grbd/bobc_hardware/CRAMPS/CRAMPS.kicad_pcb

## KiCad design CRAMPS/CRAMPS.kicad_pcb (2015-11-11)

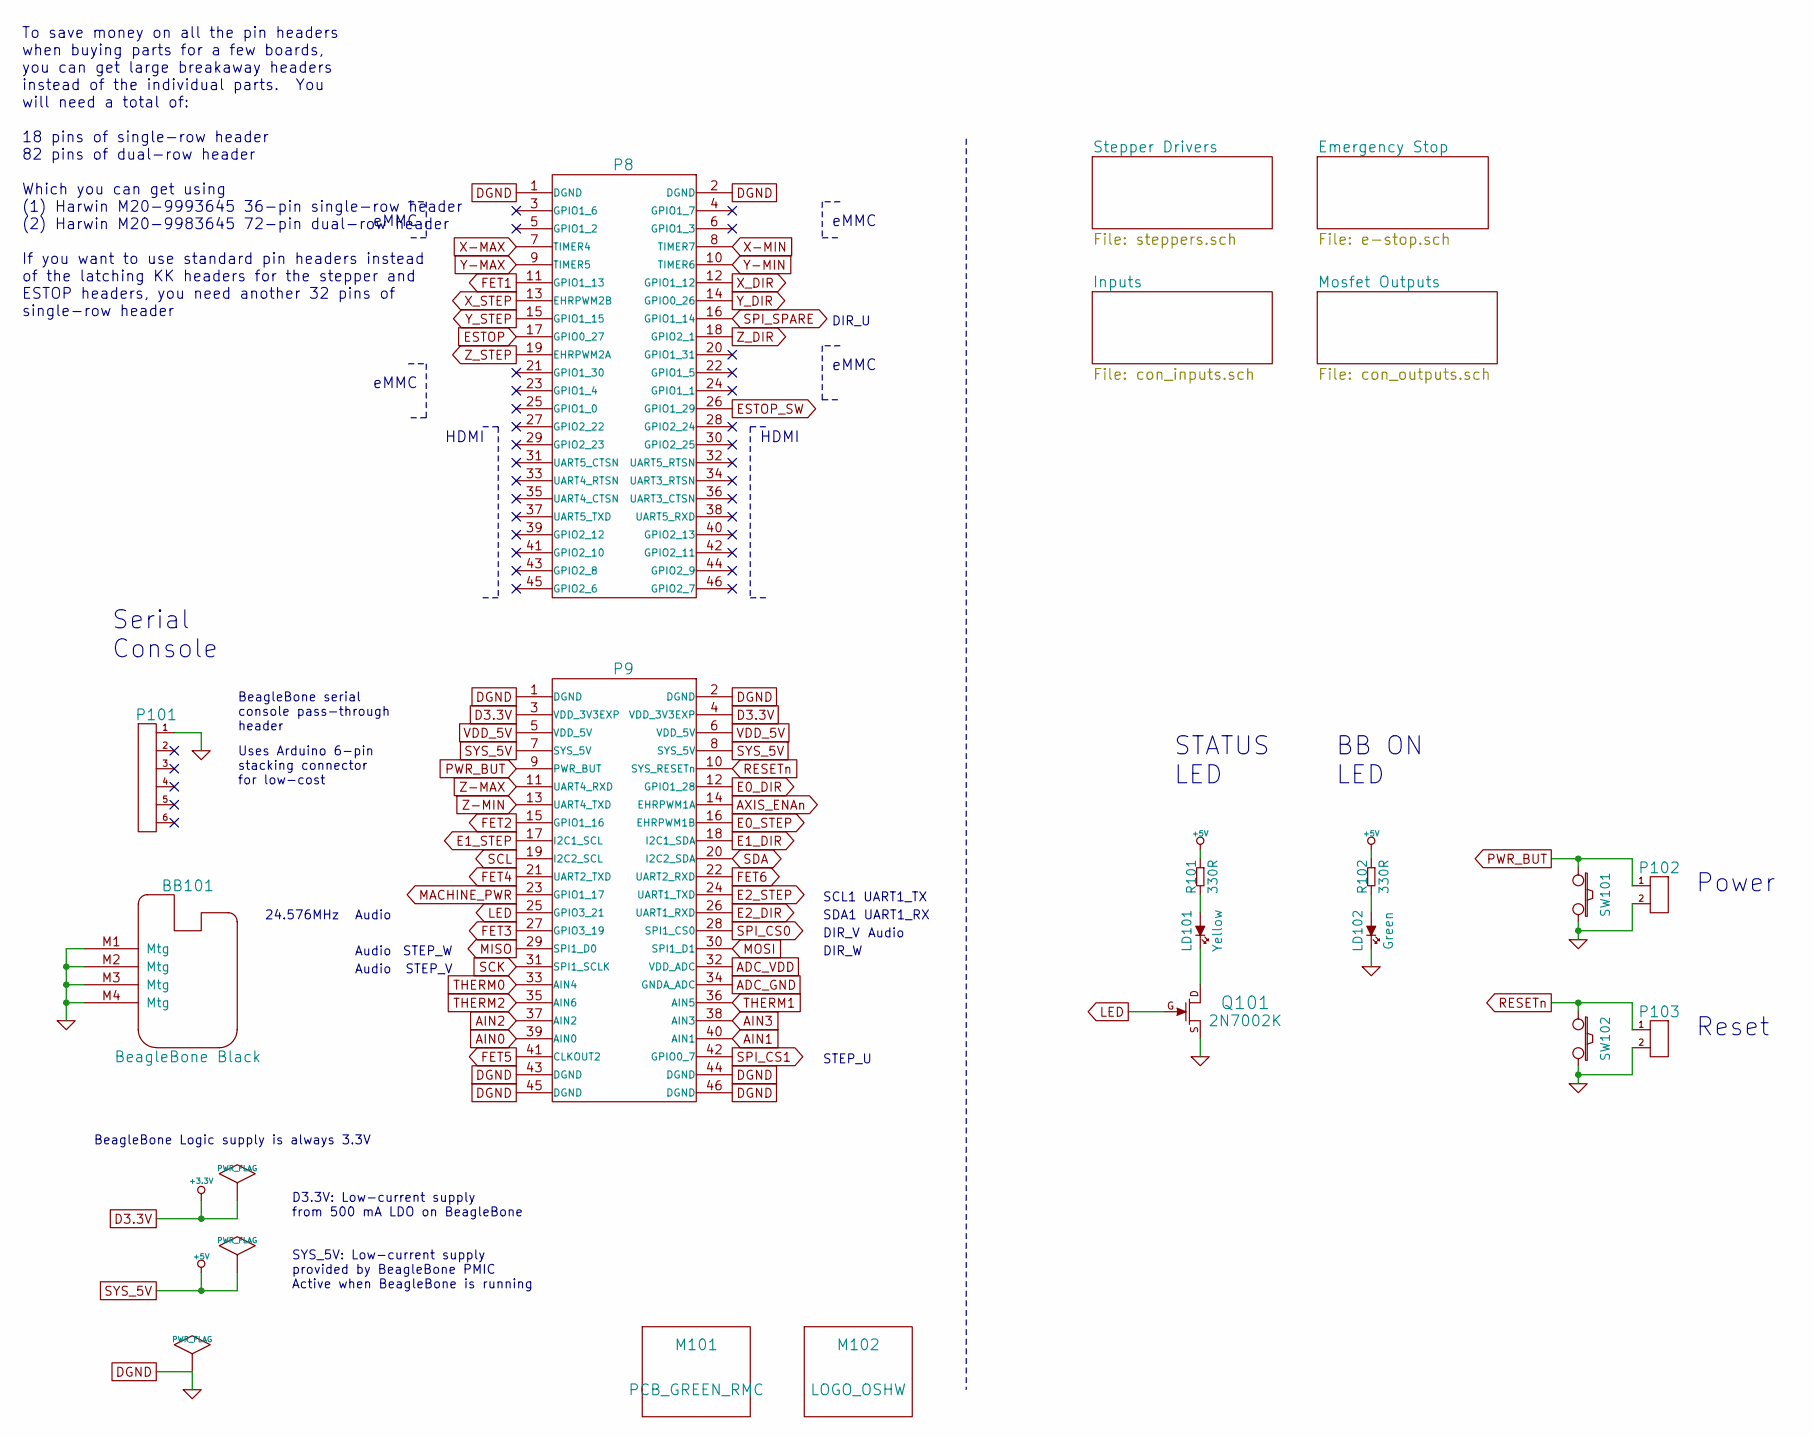
[picture p1: schematic CRAMPS.sch, CRAMPS (Cape-RAMPS for BeagleBone)]

Parts:
BB101: BeagleBone Black; BeagleBone-Pins; PartNo BB-BBLK-000
LD101: Yellow; OSRAM-LED-0603; PartNo LY Q976-P1S2-36
LD102: Green; OSRAM-LED-0603; PartNo LG Q971-KN-1
M101: PCB_GREEN_RMC; OSHW_logo_2; PartNo Part of PCB
M102: LOGO_OSHW; PCB_GREEN_RMC; PartNo Part of PCB
P8, P9: BB_EXP_CONN; P8P9_PinHeader; PartNo TSHC-123-D-06-240-GT-LF
P101: SOCKET_6_LONG; pin_strip_6; PartNo PRT-09280
P102, P103: HEADER_2; pin_strip_2; PartNo M20-9990245
Q101: 2N7002K; SOT23GDS; PartNo 2N7002K-7
R101, R102: 330R; RESC1608x55N; PartNo RMCF0603FT330R
SW101, SW102: SW_PUSH; SW_6x6_MULTI; PartNo FSM2JH

Connections:
ADC_GND: P9.34 (GNDA_ADC); also elsewhere on the board
ADC_VDD: P9.32 (VDD_ADC); also elsewhere on the board
AIN0: P9.39 (AIN0); also elsewhere on the board
AIN1: P9.40 (AIN1); also elsewhere on the board
AIN2: P9.37 (AIN2); also elsewhere on the board
AIN3: P9.38 (AIN3); also elsewhere on the board
AXIS_ENAn: P9.14 (EHRPWM1A); also elsewhere on the board
D3.3V: P9.3 (VDD_3V3EXP), P9.4 (VDD_3V3EXP); also elsewhere on the board
DGND: BB101.M1, BB101.M2, BB101.M3, BB101.M4, LD102.K, P8.1 (DGND), P8.2 (DGND), P9.1 (DGND), P9.2 (DGND), P9.43 (DGND), P9.44 (DGND), P9.45 (DGND), P9.46 (DGND), P101.1, P102.2, P103.2, Q101.S, SW101.2, SW102.2; also elsewhere on the board
E0_DIR: P9.12 (GPIO1_28); also elsewhere on the board
E0_STEP: P9.16 (EHRPWM1B); also elsewhere on the board
E1_DIR: P9.18 (I2C1_SDA); also elsewhere on the board
E1_STEP: P9.17 (I2C1_SCL); also elsewhere on the board
E2_DIR: P9.26 (UART1_RXD); also elsewhere on the board
E2_STEP: P9.24 (UART1_TXD); also elsewhere on the board
ESTOP: P8.17 (GPIO0_27); also elsewhere on the board
ESTOP_SW: P8.26 (GPIO1_29); also elsewhere on the board
FET1: P8.11 (GPIO1_13); also elsewhere on the board
FET2: P9.15 (GPIO1_16); also elsewhere on the board
FET3: P9.27 (GPIO3_19); also elsewhere on the board
FET4: P9.21 (UART2_TXD); also elsewhere on the board
FET5: P9.41 (CLKOUT2); also elsewhere on the board
FET6: P9.22 (UART2_RXD); also elsewhere on the board
LED: P9.25 (GPIO3_21), Q101.G
MACHINE_PWR: P9.23 (GPIO1_17); also elsewhere on the board
MISO: P9.29 (SPI1_D0); also elsewhere on the board
MOSI: P9.30 (SPI1_D1); also elsewhere on the board
unnamed: LD101.A, R101.2
unnamed: LD101.K, Q101.D
unnamed: LD102.A, R102.2
PWR_BUT: P9.9 (PWR_BUT), P102.1, SW101.1
RESETn: P9.10 (SYS_RESETn), P103.1, SW102.1
SCK: P9.31 (SPI1_SCLK); also elsewhere on the board
SCL: P9.19 (I2C2_SCL); also elsewhere on the board
SDA: P9.20 (I2C2_SDA); also elsewhere on the board
SPI_CS0: P9.28 (SPI1_CS0); also elsewhere on the board
SPI_CS1: P9.42 (GPIO0_7); also elsewhere on the board
SPI_SPARE: P8.16 (GPIO1_14); also elsewhere on the board
SYS_5V: P9.7 (SYS_5V), P9.8 (SYS_5V), R101.1, R102.1; also elsewhere on the board
THERM0: P9.33 (AIN4); also elsewhere on the board
THERM1: P9.36 (AIN5); also elsewhere on the board
THERM2: P9.35 (AIN6); also elsewhere on the board
VDD_5V: P9.5 (VDD_5V), P9.6 (VDD_5V); also elsewhere on the board
X-MAX: P8.7 (TIMER4); also elsewhere on the board
X-MIN: P8.8 (TIMER7); also elsewhere on the board
X_DIR: P8.12 (GPIO1_12); also elsewhere on the board
X_STEP: P8.13 (EHRPWM2B); also elsewhere on the board
Y-MAX: P8.9 (TIMER5); also elsewhere on the board
Y-MIN: P8.10 (TIMER6); also elsewhere on the board
Y_DIR: P8.14 (GPIO0_26); also elsewhere on the board
Y_STEP: P8.15 (GPIO1_15); also elsewhere on the board
Z-MAX: P9.11 (UART4_RXD); also elsewhere on the board
Z-MIN: P9.13 (UART4_TXD); also elsewhere on the board
Z_DIR: P8.18 (GPIO2_1); also elsewhere on the board
Z_STEP: P8.19 (EHRPWM2A); also elsewhere on the board

Notes on the sheet:
STATUS LED
HDMI
eMMC
24.576MHz
Audio
BeagleBone serial console pass-through header
SCL1 UART1_TX
SDA1 UART1_RX
To save money on all the pin headers when buying parts for a few boards, you can get large breakaway headers instead of the individual parts. You will need a total of: 18 pins of single-row header 82 pins of dual-row header Which you can get using (1) Harwin M20-9993645 36-pin single-row header (2)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
BB ON LED
BeagleBone Logic supply is always 3.3V
SYS_5V: Low-current supply provided by BeagleBone PMIC Active when BeagleBone is running
D3.3V: Low-current supply from 500 mA LDO on BeagleBone
Serial Console
Uses Arduino 6-pin stacking connector for low-cost
Power
Reset
STEP_U
STEP_V
STEP_W
DIR_U
DIR_V
DIR_W

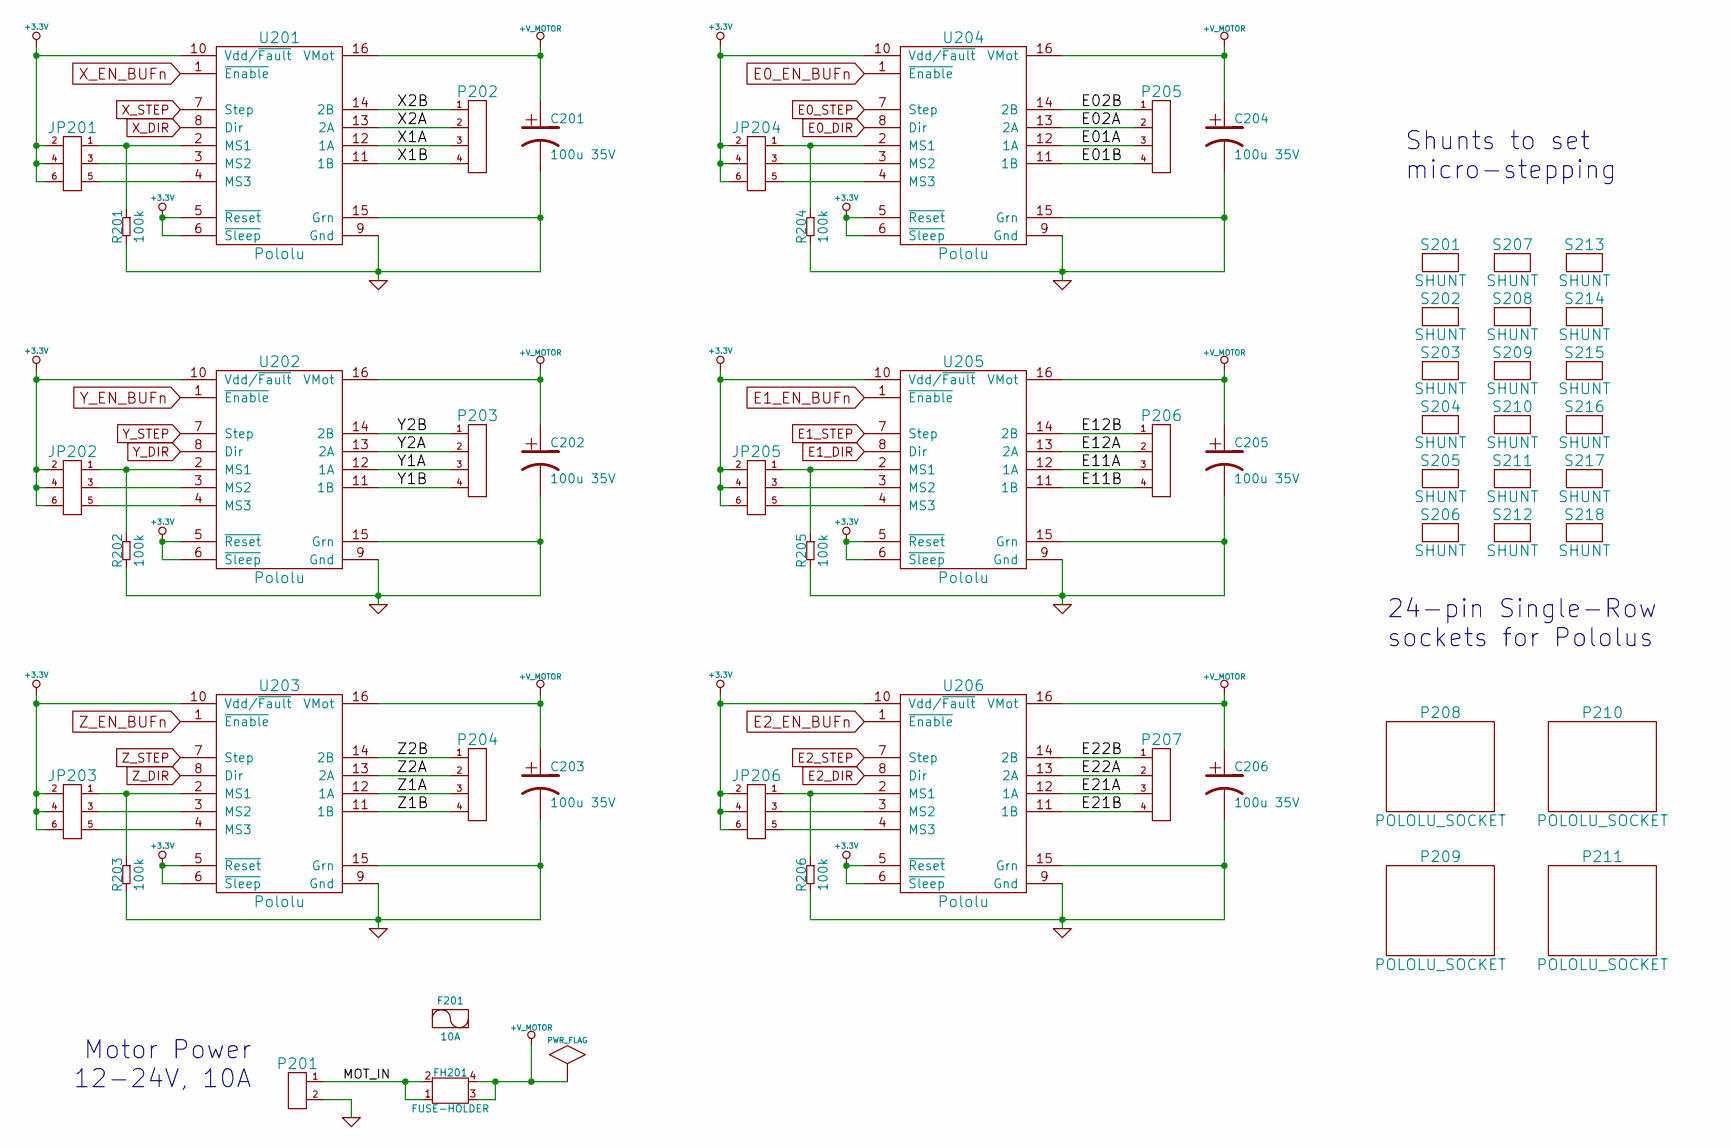
[picture p2: schematic steppers.sch, CRAMPS (Cape-RAMPS for BeagleBone)]

Parts:
C201, C202, C203, C204, C205, C206: 100u 35V; c_elec_6.3x7.7; PartNo UCD1V101MCL6GS
F201: 10A; Fuse-Loose; PartNo 0297010.WXNV
FH201: FUSE-HOLDER; Keystone-3568; PartNo 3568
JP201, JP202, JP203, JP204, JP205, JP206: HEADER_3X2; pin_strip_3x2; PartNo M20-9980345
P201: PT_2,5-2-5,0-H; PartNo 1935776
P202, P203, P204, P205, P206, P207: KK-2.54-4W; CONN_KK_2.54_4W; PartNo 22-23-2041
P208, P209, P210, P211: POLOLU_SOCKET; Pololu_Socket; PartNo PPTC241LFBN-RC
R201, R202, R203, R204, R205, R206: 100k; RESC1608x55N; PartNo RMCF0603FT100K
S201, S202, S203, S204, S205, S206, S207, S208, S209, S210, S211, S212, S213, S214, S215, S216, S217, S218: SHUNT; Shunt; PartNo 382811-8
U201, U202, U203, U204, U205, U206: Pololu; POLOLU; PartNo DRV8825

Connections:
+V_MOTOR: C201.1, C202.1, C203.1, C204.1, C205.1, C206.1, FH201.3, FH201.4, U201.16 (VMot), U202.16 (VMot), U203.16 (VMot), U204.16 (VMot), U205.16 (VMot), U206.16 (VMot); also elsewhere on the board
/Stepper Drivers/E01A: P205.3, U204.12 (1A)
/Stepper Drivers/E01B: P205.4, U204.11 (1B)
/Stepper Drivers/E02A: P205.2, U204.13 (2A)
/Stepper Drivers/E02B: P205.1, U204.14 (2B)
/Stepper Drivers/E11A: P206.3, U205.12 (1A)
/Stepper Drivers/E11B: P206.4, U205.11 (1B)
/Stepper Drivers/E12A: P206.2, U205.13 (2A)
/Stepper Drivers/E12B: P206.1, U205.14 (2B)
/Stepper Drivers/E21A: P207.3, U206.12 (1A)
/Stepper Drivers/E21B: P207.4, U206.11 (1B)
/Stepper Drivers/E22A: P207.2, U206.13 (2A)
/Stepper Drivers/E22B: P207.1, U206.14 (2B)
/Stepper Drivers/MOT_IN: FH201.1, FH201.2, P201.1
/Stepper Drivers/X1A: P202.3, U201.12 (1A)
/Stepper Drivers/X1B: P202.4, U201.11 (1B)
/Stepper Drivers/X2A: P202.2, U201.13 (2A)
/Stepper Drivers/X2B: P202.1, U201.14 (2B)
/Stepper Drivers/Y1A: P203.3, U202.12 (1A)
/Stepper Drivers/Y1B: P203.4, U202.11 (1B)
/Stepper Drivers/Y2A: P203.2, U202.13 (2A)
/Stepper Drivers/Y2B: P203.1, U202.14 (2B)
/Stepper Drivers/Z1A: P204.3, U203.12 (1A)
/Stepper Drivers/Z1B: P204.4, U203.11 (1B)
/Stepper Drivers/Z2A: P204.2, U203.13 (2A)
/Stepper Drivers/Z2B: P204.1, U203.14 (2B)
D3.3V: JP201.2, JP201.4, JP201.6, JP202.2, JP202.4, JP202.6, JP203.2, JP203.4, JP203.6, JP204.2, JP204.4, JP204.6, JP205.2, JP205.4, JP205.6, JP206.2, JP206.4, JP206.6, U201.5 (~Reset), U201.6 (~Sleep), U201.10 (Vdd/~Fault), U202.5 (~Reset), U202.6 (~Sleep), U202.10 (Vdd/~Fault), U203.5 (~Reset), U203.6 (~Sleep), U203.10 (Vdd/~Fault), U204.5 (~Reset), U204.6 (~Sleep), U204.10 (Vdd/~Fault), U205.5 (~Reset), U205.6 (~Sleep), U205.10 (Vdd/~Fault), U206.5 (~Reset), U206.6 (~Sleep), U206.10 (Vdd/~Fault); also elsewhere on the board
DGND: C201.2, C202.2, C203.2, C204.2, C205.2, C206.2, P201.2, R201.2, R202.2, R203.2, R204.2, R205.2, R206.2, U201.9 (Gnd), U201.15 (Grn), U202.9 (Gnd), U202.15 (Grn), U203.9 (Gnd), U203.15 (Grn), U204.9 (Gnd), U204.15 (Grn), U205.9 (Gnd), U205.15 (Grn), U206.9 (Gnd), U206.15 (Grn); also elsewhere on the board
E0_DIR: U204.8 (Dir); also elsewhere on the board
E0_EN_BUFn: U201.1 (~Enable), U202.1 (~Enable), U203.1 (~Enable), U204.1 (~Enable), U205.1 (~Enable), U206.1 (~Enable); also elsewhere on the board
E0_STEP: U204.7 (Step); also elsewhere on the board
E1_DIR: U205.8 (Dir); also elsewhere on the board
E1_STEP: U205.7 (Step); also elsewhere on the board
E2_DIR: U206.8 (Dir); also elsewhere on the board
E2_STEP: U206.7 (Step); also elsewhere on the board
unnamed: JP201.1, R201.1, U201.2 (MS1)
unnamed: JP201.3, U201.3 (MS2)
unnamed: JP201.5, U201.4 (MS3)
unnamed: JP202.1, R202.1, U202.2 (MS1)
unnamed: JP202.3, U202.3 (MS2)
unnamed: JP202.5, U202.4 (MS3)
unnamed: JP203.1, R203.1, U203.2 (MS1)
unnamed: JP203.3, U203.3 (MS2)
unnamed: JP203.5, U203.4 (MS3)
unnamed: JP204.1, R204.1, U204.2 (MS1)
unnamed: JP204.3, U204.3 (MS2)
unnamed: JP204.5, U204.4 (MS3)
unnamed: JP205.1, R205.1, U205.2 (MS1)
unnamed: JP205.3, U205.3 (MS2)
unnamed: JP205.5, U205.4 (MS3)
unnamed: JP206.1, R206.1, U206.2 (MS1)
unnamed: JP206.3, U206.3 (MS2)
unnamed: JP206.5, U206.4 (MS3)
X_DIR: U201.8 (Dir); also elsewhere on the board
X_STEP: U201.7 (Step); also elsewhere on the board
Y_DIR: U202.8 (Dir); also elsewhere on the board
Y_STEP: U202.7 (Step); also elsewhere on the board
Z_DIR: U203.8 (Dir); also elsewhere on the board
Z_STEP: U203.7 (Step); also elsewhere on the board

Notes on the sheet:
Motor Power 12-24V, 10A
24-pin Single-Row sockets for Pololus
Shunts to set micro-stepping

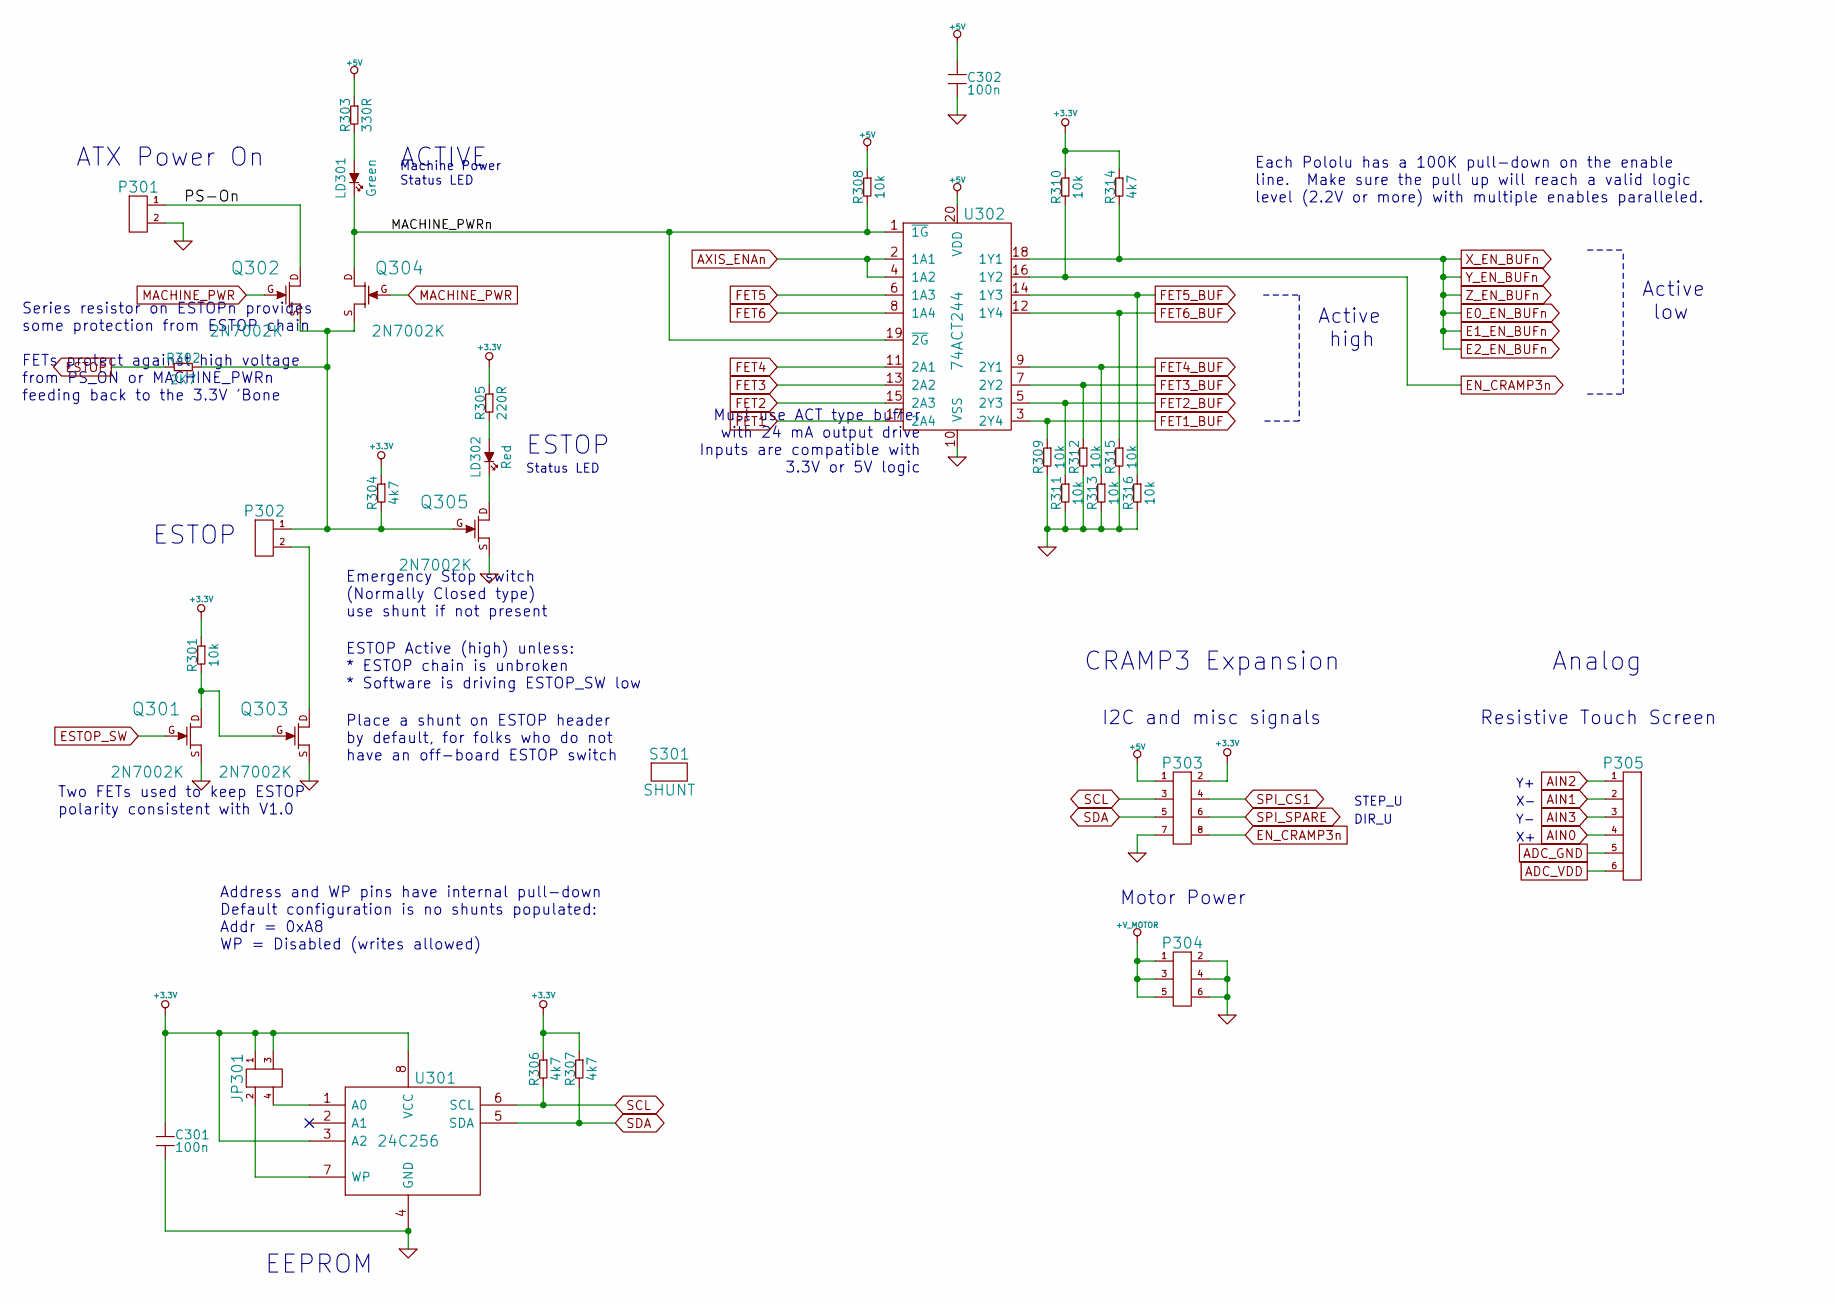
[picture p3: schematic e-stop.sch, CRAMPS (Cape-RAMPS for BeagleBone)]

Parts:
C301, C302: 100n; CAPC1608x55N; PartNo GRM188R71C104KA01D
JP301: HEADER_2X2; pin_strip_2x2; PartNo M20-9980245
LD301: Green; OSRAM-LED-0603; PartNo LG Q971-KN-1
LD302: Red; OSRAM-LED-0603; PartNo LS Q976-NR-1
P301: HEADER_2; pin_strip_2; PartNo M20-9990245
P302: KK-2.54-2W; CONN_KK_2.54_2W; PartNo 22-23-2021
P303: HEADER_4X2; pin_strip_4x2; PartNo M20-9980445
P304: HEADER_3X2; pin_strip_3x2; PartNo M20-9980345
P305: HEADER_6; pin_strip_6; PartNo M20-9990645
Q301, Q302, Q303, Q304, Q305: 2N7002K; SOT23GDS; PartNo 2N7002K-7
R301, R308, R309, R310, R311, R312, R313, R315, R316: 10k; RESC1608x55N; PartNo RMCF0603FT10K0
R302: 2K7; RESC1608x55N; PartNo RMCF0603FT2K70
R303: 330R; RESC1608x55N; PartNo RMCF0603FT330R
R304, R306, R307, R314: 4k7; RESC1608x55N; PartNo RMCF0603FT4K70
R305: 220R; RESC1608x55N; PartNo RMCF0603FT220R
S301: SHUNT; Shunt; PartNo 382811-8
U301: 24C256; SOIC127P600X175-8AN; PartNo CAT24C256WI-GT3
U302: 74ACT244; SOIC127P1032X265-20N; PartNo 74ACT244SCX

Connections:
+V_MOTOR: P304.1, P304.3, P304.5; also elsewhere on the board
/Emergency Stop/MACHINE_PWRn: LD301.K, Q304.D, R308.2, U302.1 (~1G), U302.19 (~2G)
/Emergency Stop/PS-On: P301.1, Q302.D
ADC_GND: P305.5; also elsewhere on the board
ADC_VDD: P305.6; also elsewhere on the board
AIN0: P305.4; also elsewhere on the board
AIN1: P305.2; also elsewhere on the board
AIN2: P305.1; also elsewhere on the board
AIN3: P305.3; also elsewhere on the board
AXIS_ENAn: U302.2 (1A1), U302.4 (1A2); also elsewhere on the board
D3.3V: C301.1, JP301.1, JP301.3, P303.2, R301.1, R304.1, R305.1, R306.1, R307.1, R310.1, R314.1, U301.3 (A2), U301.8 (VCC); also elsewhere on the board
DGND: C301.2, C302.2, P301.2, P303.7, P304.2, P304.4, P304.6, Q301.S, Q303.S, Q305.S, R309.2, R311.2, R312.2, R313.2, R315.2, R316.2, U301.4 (GND), U302.10 (VSS); also elsewhere on the board
E0_EN_BUFn: R314.2, U302.18 (1Y1); also elsewhere on the board
EN_CRAMP3n: P303.8, R310.2, U302.16 (1Y2)
ESTOP: R302.2; also elsewhere on the board
ESTOP_SW: Q301.G; also elsewhere on the board
FET1: U302.17 (2A4); also elsewhere on the board
FET1_BUF: R309.1, U302.3 (2Y4); also elsewhere on the board
FET2: U302.15 (2A3); also elsewhere on the board
FET2_BUF: R311.1, U302.5 (2Y3); also elsewhere on the board
FET3: U302.13 (2A2); also elsewhere on the board
FET3_BUF: R312.1, U302.7 (2Y2); also elsewhere on the board
FET4: U302.11 (2A1); also elsewhere on the board
FET4_BUF: R313.1, U302.9 (2Y1); also elsewhere on the board
FET5: U302.6 (1A3); also elsewhere on the board
FET5_BUF: R316.1, U302.14 (1Y3); also elsewhere on the board
FET6: U302.8 (1A4); also elsewhere on the board
FET6_BUF: R315.1, U302.12 (1Y4); also elsewhere on the board
MACHINE_PWR: Q302.G, Q304.G; also elsewhere on the board
unnamed: JP301.2, U301.7 (WP)
unnamed: JP301.4, U301.1 (A0)
unnamed: LD301.A, R303.2
unnamed: LD302.A, R305.2
unnamed: LD302.K, Q305.D
unnamed: P302.1, Q302.S, Q304.S, Q305.G, R302.1, R304.2
unnamed: P302.2, Q303.D
unnamed: Q301.D, Q303.G, R301.2
SCL: P303.3, R306.2, U301.6 (SCL); also elsewhere on the board
SDA: P303.5, R307.2, U301.5 (SDA); also elsewhere on the board
SPI_CS1: P303.4; also elsewhere on the board
SPI_SPARE: P303.6; also elsewhere on the board
SYS_5V: C302.1, P303.1, R303.1, R308.1, U302.20 (VDD); also elsewhere on the board

Notes on the sheet:
Emergency Stop switch (Normally Closed type) use shunt if not present
Active low
Active high
Must use ACT type buffer with 24 mA output drive Inputs are compatible with 3.3V or 5V logic
Each Pololu has a 100K pull-down on the enable line. Make sure the pull up will reach a valid logic level (2.2V or more) with multiple enables paralleled.
ESTOP Active (high) unless: * ESTOP chain is unbroken * Software is driving ESTOP_SW low
Machine Power Status LED
EEPROM
Address and WP pins have internal pull-down Default configuration is no shunts populated: Addr = 0xA8 WP = Disabled (writes allowed)
I2C and misc signals
Analog
Resistive Touch Screen
ATX Power On
Two FETs used to keep ESTOP polarity consistent with V1.0
ESTOP
Place a shunt on ESTOP header by default, for folks who do not have an off-board ESTOP switch
Motor Power
CRAMP3 Expansion
Series resistor on ESTOPn provides some protection from ESTOP chain FETs protect against high voltage from PS_ON or MACHINE_PWRn feeding back to the 3.3V 'Bone
ACTIVE
Status LED
STEP_U
DIR_U

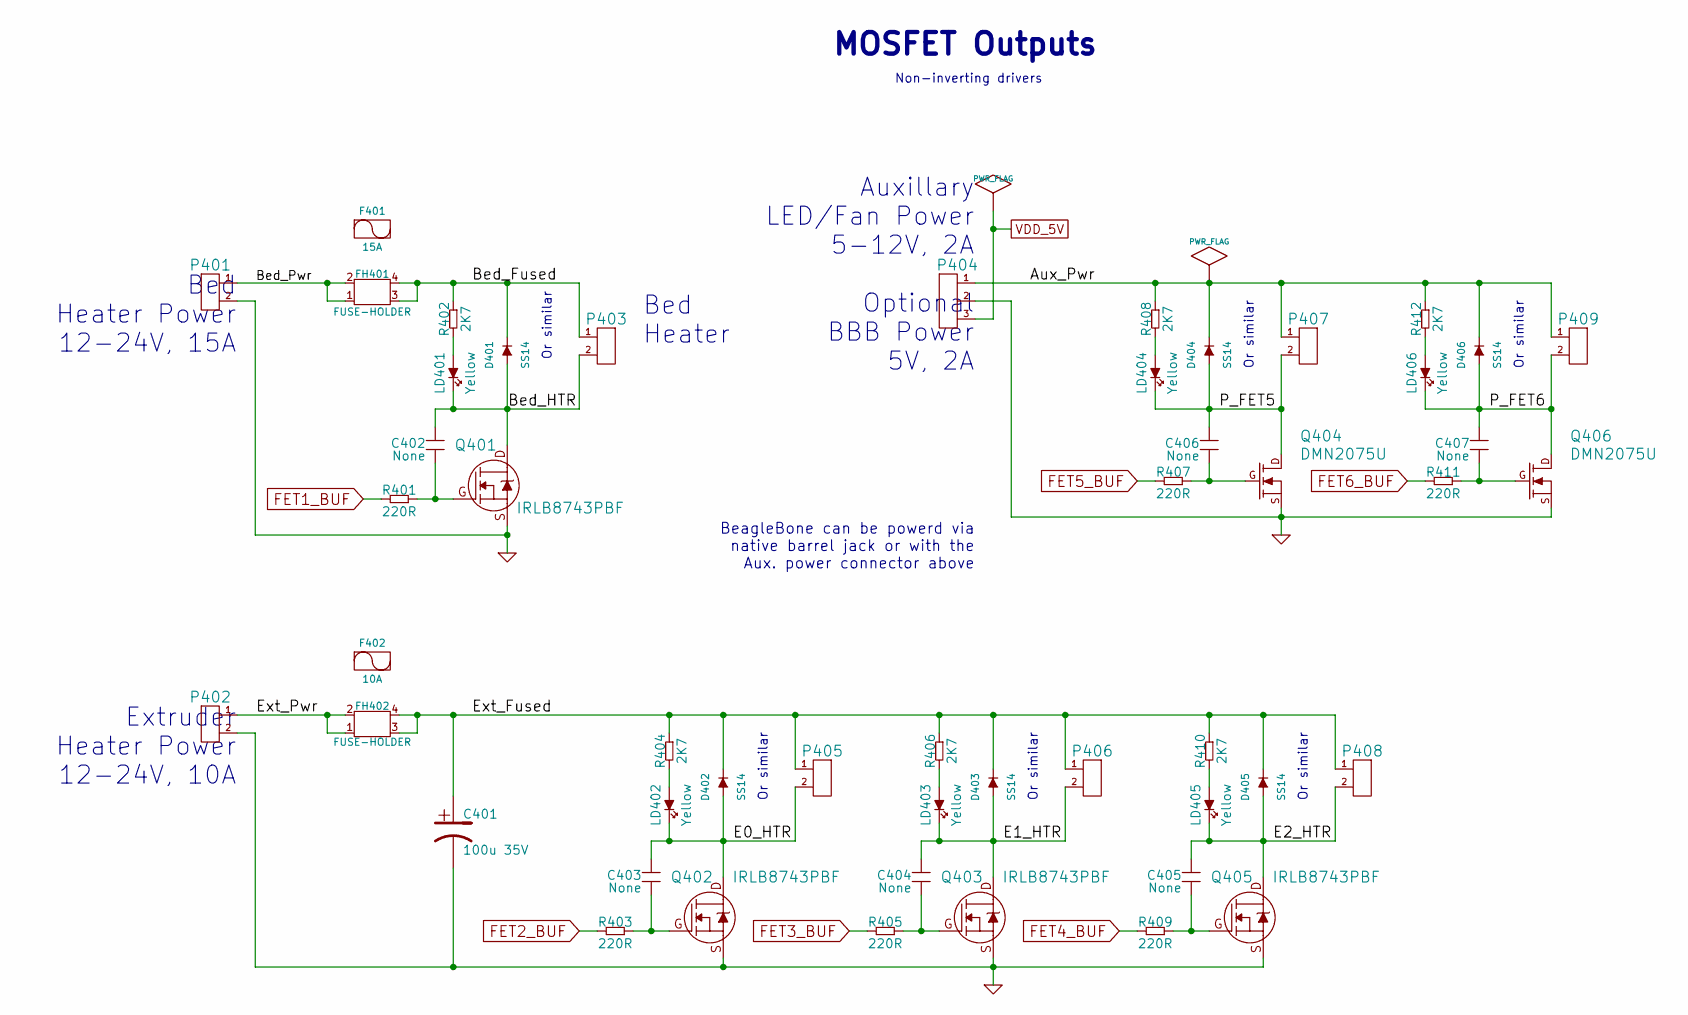
[picture p4: schematic con_outputs.sch, CRAMPS (Cape-RAMPS for BeagleBone)]

Parts:
C401: 100u 35V; c_elec_6.3x7.7; PartNo UCD1V101MCL6GS
C402, C403, C404, C405, C406, C407: None; CAPC1608x55N; PartNo Do Not Populate
D401, D402, D403, D404, D405, D406: SS14; DIOM5127X229N; PartNo SS14-E3/61T
F401: 15A; Fuse-Loose; PartNo 0297015.WXNV
F402: 10A; Fuse-Loose; PartNo 0297010.WXNV
FH401, FH402: FUSE-HOLDER; Keystone-3568; PartNo 3568
LD401, LD402, LD403, LD404, LD405, LD406: Yellow; OSRAM-LED-0603; PartNo LY Q976-P1S2-36
P401, P402, P403: PT_2,5-2-5,0-H; PartNo 1935776
P404: PT_1,5-3-3,5-H; PartNo 1984620
P405, P406, P408: PT_1,5-2-3,5-H; PartNo 1984617
P407, P409: KK-2.54-2W; CONN_KK_2.54_2W; PartNo 22-23-2021
Q401, Q402, Q403, Q405: IRLB8743PBF; TO-220AB_IRF2804_RMC; PartNo IRLB8743PBF
Q404, Q406: DMN2075U; SOT23GDS; PartNo DMN2075U-7
R401, R403, R405, R407, R409, R411: 220R; RESC1608x55N; PartNo RMCF0603FT220R
R402, R404, R406, R408, R410, R412: 2K7; RESC1608x55N; PartNo RMCF0603FT2K70

Connections:
/Mosfet Outputs/Aux_Pwr: D404.K, D406.K, P404.1, P407.1, P409.1, R408.1, R412.1
/Mosfet Outputs/Bed_Fused: D401.K, FH401.3, FH401.4, P403.1, R402.1
/Mosfet Outputs/Bed_HTR: C402.1, D401.A, LD401.K, P403.2, Q401.D
/Mosfet Outputs/Bed_Pwr: FH401.1, FH401.2, P401.1
/Mosfet Outputs/E0_HTR: C403.1, D402.A, LD402.K, P405.2, Q402.D
/Mosfet Outputs/E1_HTR: C404.1, D403.A, LD403.K, P406.2, Q403.D
/Mosfet Outputs/E2_HTR: C405.1, D405.A, LD405.K, P408.2, Q405.D
/Mosfet Outputs/Ext_Fused: C401.1, D402.K, D403.K, D405.K, FH402.3, FH402.4, P405.1, P406.1, P408.1, R404.1, R406.1, R410.1
/Mosfet Outputs/Ext_Pwr: FH402.1, FH402.2, P402.1
/Mosfet Outputs/P_FET5: C406.1, D404.A, LD404.K, P407.2, Q404.D
/Mosfet Outputs/P_FET6: C407.1, D406.A, LD406.K, P409.2, Q406.D
DGND: C401.2, P401.2, P402.2, P404.2, Q401.S, Q402.S, Q403.S, Q404.S, Q405.S, Q406.S; also elsewhere on the board
FET1_BUF: R401.2; also elsewhere on the board
FET2_BUF: R403.2; also elsewhere on the board
FET3_BUF: R405.2; also elsewhere on the board
FET4_BUF: R409.2; also elsewhere on the board
FET5_BUF: R407.2; also elsewhere on the board
FET6_BUF: R411.2; also elsewhere on the board
unnamed: C402.2, Q401.G, R401.1
unnamed: C403.2, Q402.G, R403.1
unnamed: C404.2, Q403.G, R405.1
unnamed: C405.2, Q405.G, R409.1
unnamed: C406.2, Q404.G, R407.1
unnamed: C407.2, Q406.G, R411.1
unnamed: LD401.A, R402.2
unnamed: LD402.A, R404.2
unnamed: LD403.A, R406.2
unnamed: LD404.A, R408.2
unnamed: LD405.A, R410.2
unnamed: LD406.A, R412.2
VDD_5V: P404.3; also elsewhere on the board

Notes on the sheet:
Non-inverting drivers
MOSFET Outputs
Or similar
Bed Heater Power 12-24V, 15A
Bed Heater
Extruder Heater Power 12-24V, 10A
Auxillary LED/Fan Power 5-12V, 2A Optional BBB Power 5V, 2A
BeagleBone can be powerd via native barrel jack or with the Aux. power connector above

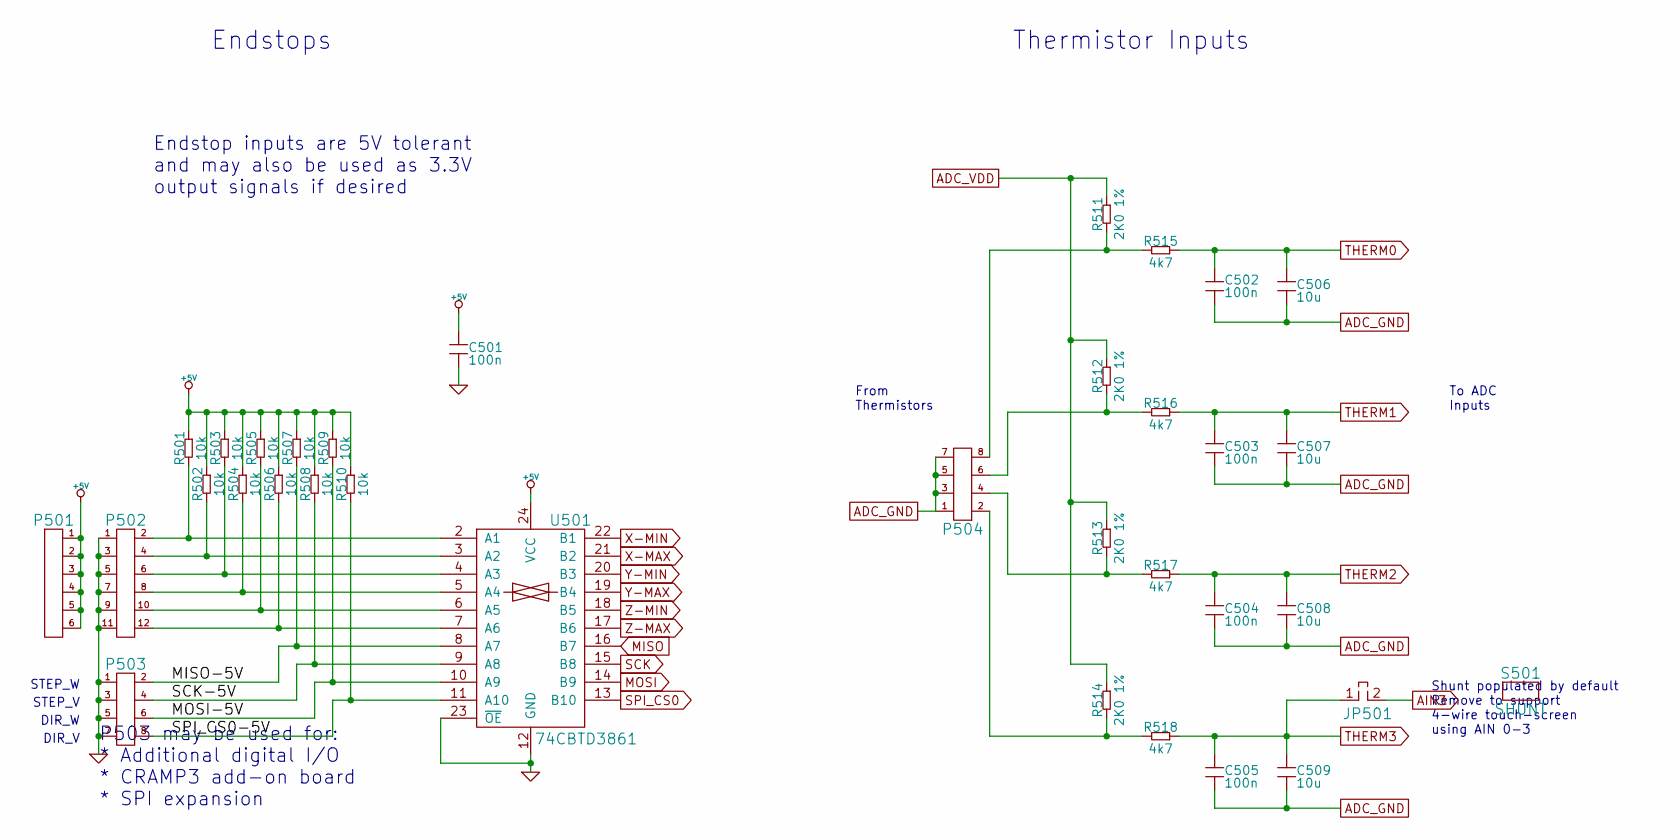
[picture p5: schematic con_inputs.sch, CRAMPS (Cape-RAMPS for BeagleBone)]

Parts:
C501, C502, C503, C504, C505: 100n; CAPC1608x55N; PartNo GRM188R71C104KA01D
C506, C507, C508, C509: 10u; CAPC1608x55N; PartNo JMK107ABJ106MAHT
JP501: HEADER_2; pin_strip_2; PartNo M20-9990245
P501: HEADER_6; pin_strip_6; PartNo M20-9990645
P502: HEADER_6X2; pin_strip_6x2; PartNo M20-9980645
P503, P504: HEADER_4X2; pin_strip_4x2; PartNo M20-9980445
R501, R502, R503, R504, R505, R506, R507, R508, R509, R510: 10k; RESC1608x55N; PartNo RMCF0603FT10K0
R511, R512, R513, R514: 2K0 1%; RESC1608x55N; PartNo RMCF0603FT2K00
R515, R516, R517, R518: 4k7; RESC1608x55N; PartNo RMCF0603FT4K70
S501: SHUNT; Shunt; PartNo 382811-8
U501: 74CBTD3861; SOIC127P1030X265-24N

Connections:
/Inputs/MISO-5V: P503.2, R507.2, U501.8 (A7)
/Inputs/MOSI-5V: P503.6, R509.2, U501.10 (A9)
/Inputs/SCK-5V: P503.4, R508.2, U501.9 (A8)
/Inputs/SPI_CS0-5V: P503.8, R510.2, U501.11 (A10)
ADC_GND: C502.2, C503.2, C504.2, C505.2, C506.2, C507.2, C508.2, C509.2, P504.1, P504.3, P504.5, P504.7; also elsewhere on the board
ADC_VDD: R511.1, R512.1, R513.1, R514.1; also elsewhere on the board
AIN3: JP501.2; also elsewhere on the board
DGND: C501.2, P502.1, P502.3, P502.5, P502.7, P502.9, P502.11, P503.1, P503.3, P503.5, P503.7, U501.12 (GND), U501.23 (~OE); also elsewhere on the board
MISO: U501.16 (B7); also elsewhere on the board
MOSI: U501.14 (B9); also elsewhere on the board
unnamed: P502.2, R501.2, U501.2 (A1)
unnamed: P502.4, R502.2, U501.3 (A2)
unnamed: P502.6, R503.2, U501.4 (A3)
unnamed: P502.8, R504.2, U501.5 (A4)
unnamed: P502.10, R505.2, U501.6 (A5)
unnamed: P502.12, R506.2, U501.7 (A6)
unnamed: P504.2, R514.2, R518.2
unnamed: P504.4, R513.2, R517.2
unnamed: P504.6, R512.2, R516.2
unnamed: P504.8, R511.2, R515.2
SCK: U501.15 (B8); also elsewhere on the board
SPI_CS0: U501.13 (B10); also elsewhere on the board
SYS_5V: C501.1, P501.1, P501.2, P501.3, P501.4, P501.5, P501.6, R501.1, R502.1, R503.1, R504.1, R505.1, R506.1, R507.1, R508.1, R509.1, R510.1, U501.24 (VCC); also elsewhere on the board
THERM0: C502.1, C506.1, R515.1; also elsewhere on the board
THERM1: C503.1, C507.1, R516.1; also elsewhere on the board
THERM2: C504.1, C508.1, R517.1; also elsewhere on the board
THERM3: C505.1, C509.1, JP501.1, R518.1
X-MAX: U501.21 (B2); also elsewhere on the board
X-MIN: U501.22 (B1); also elsewhere on the board
Y-MAX: U501.19 (B4); also elsewhere on the board
Y-MIN: U501.20 (B3); also elsewhere on the board
Z-MAX: U501.17 (B6); also elsewhere on the board
Z-MIN: U501.18 (B5); also elsewhere on the board

Notes on the sheet:
Endstop inputs are 5V tolerant and may also be used as 3.3V output signals if desired
Endstops
From Thermistors
Thermistor Inputs
Shunt populated by default Remove to support 4-wire touch-screen using AIN 0-3
To ADC Inputs
P503 may be used for: * Additional digital I/O * CRAMP3 add-on board * SPI expansion
STEP_V
STEP_W
DIR_V
DIR_W
