grbd/bobc_hardware/CRAMPS/CRAMPS.kicad_pcb

## KiCad design CRAMPS/CRAMPS.kicad_pcb (continued)

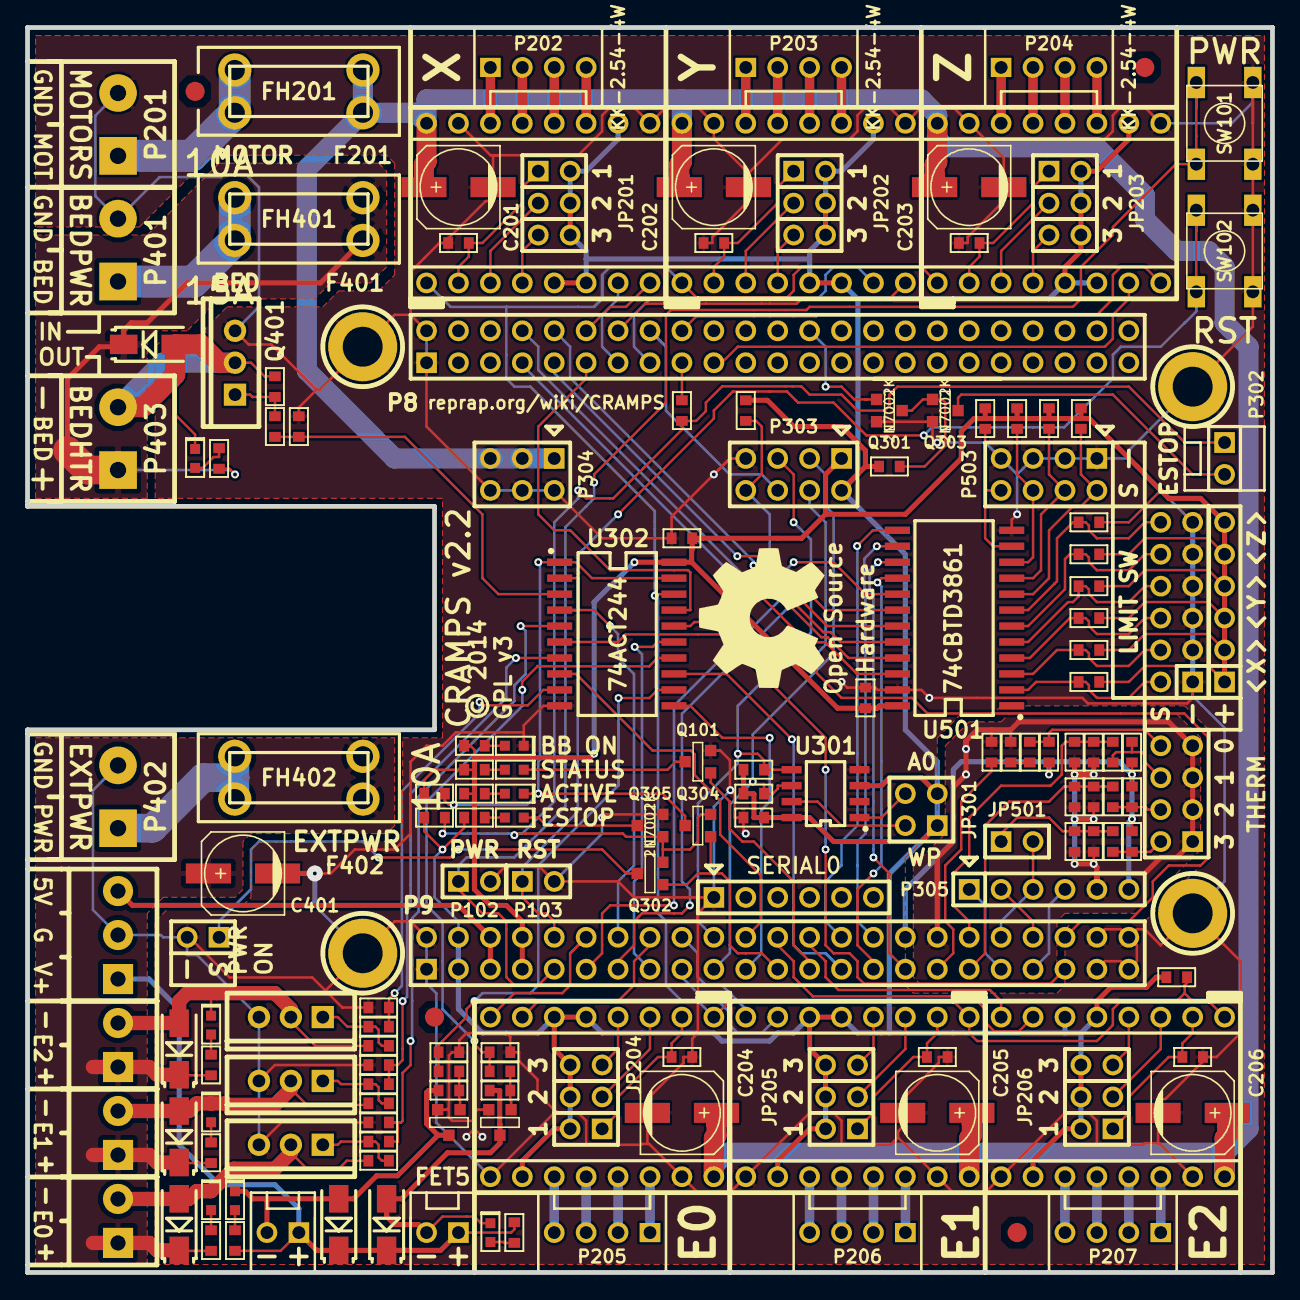
[picture p6: board CRAMPS.kicad_pcb from above]

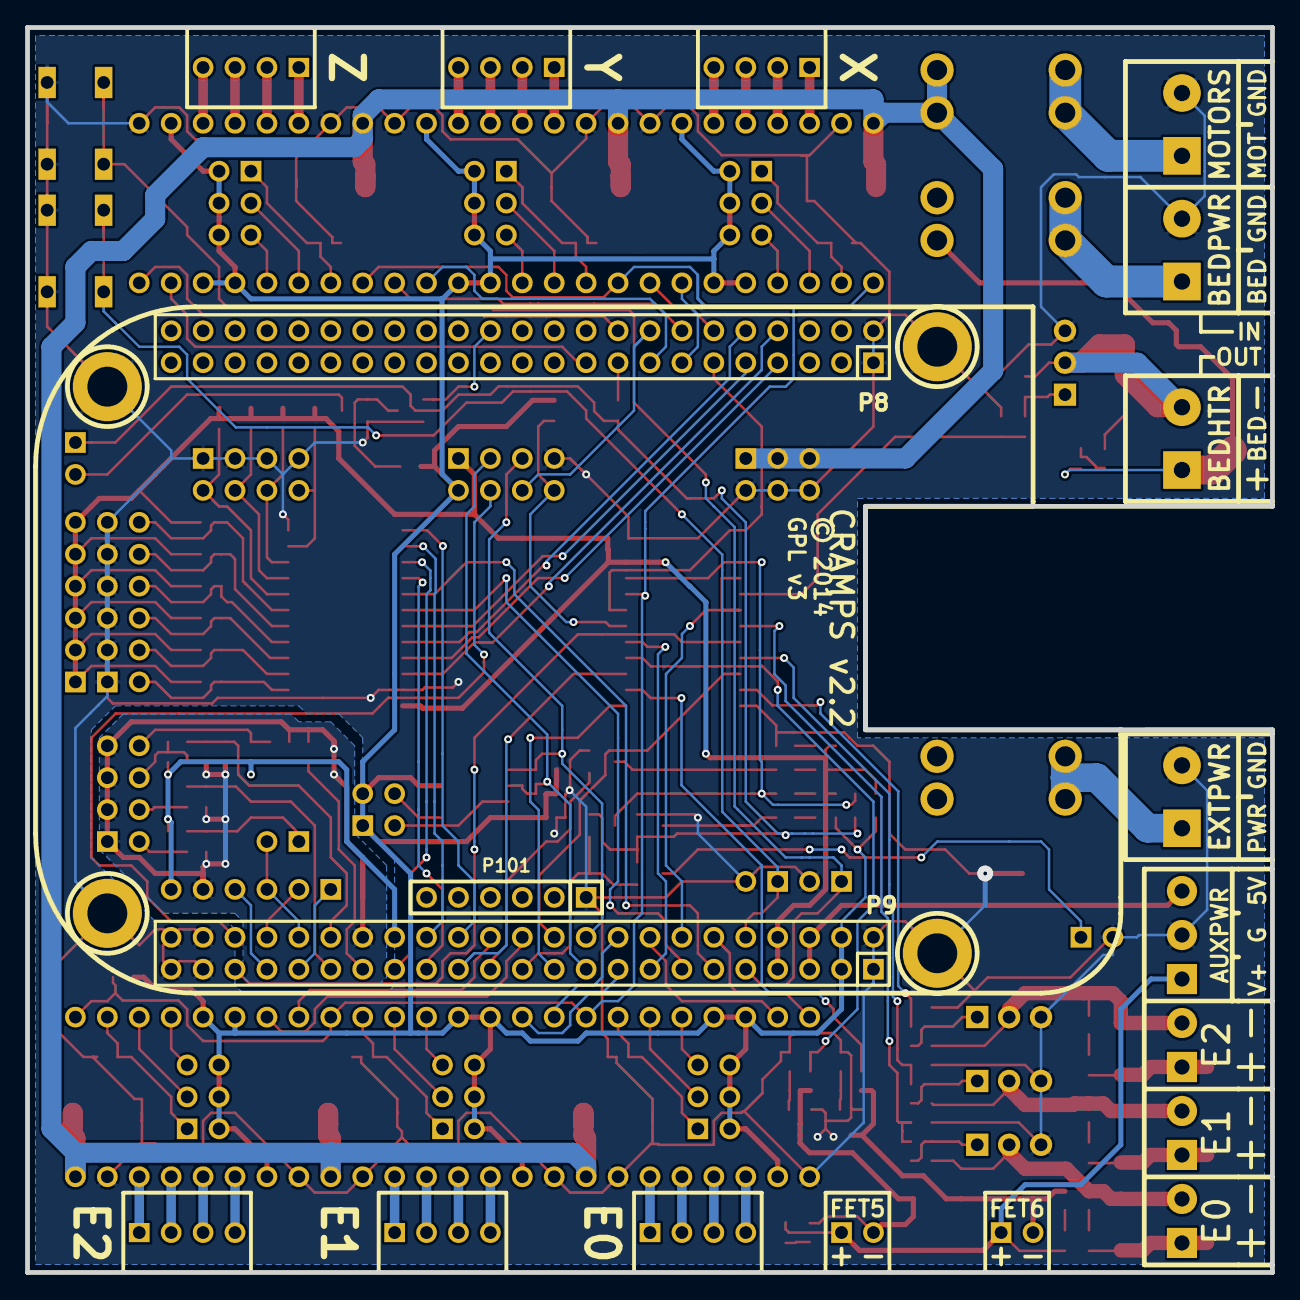
[picture p7: board CRAMPS.kicad_pcb from below]

Board: 2 copper layers, 99.1 x 99.1 mm, 192 parts (4 on the bottom side), 155 nets.

Other parts of the board:
FID1, FID2, FID3, FID4: VAL**; FIDUCIAL-060
