grbd/bobc_hardware/(commit log)

2015-11-11 Updated schematic for new Kicad
    [CRAMPS.sch, con_inputs.sch, con_outputs.sch, e-stop.sch, steppers.sch]
2015-11-11 Fixed the pcb associations in the schematic
    [CRAMPS.sch, con_inputs.sch, con_outputs.sch, e-stop.sch, steppers.sch]
2015-11-11 updated the PCB with new netlist
    [CRAMPS.kicad_pcb]
