grbd/bobc_hardware/(notices)

Notices in the files:
CRAMPS/con_outputs.sch:
Copyright 2014 GPL v3
CRAMPS/CRAMPS.kicad_pcb:
© 2014
GPL v3
